portlandrobotics/btServo/README.md

btServo
=======

PARTS hobby servo controller project
