portlandrobotics/btServo/hardware/kicad/parts_servo.kicad_pcb

## KiCad design hardware/kicad/parts_servo.kicad_pcb (2015-05-14)

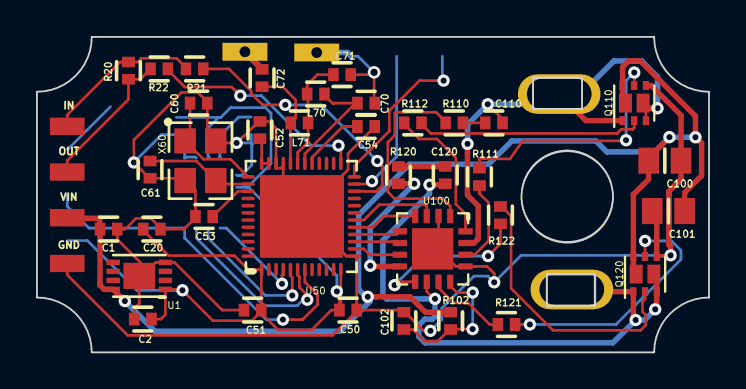
[picture p1: board parts_servo.kicad_pcb from above]

Board: 2 copper layers, 37.3 x 17.5 mm, 47 parts (0 on the bottom side), 43 nets.

Parts:
C1: 1uF 10V; 0402-B
C2, C102, C110, C120: 1uF; 0402-B
C20, C50, C51, C53, C203: 0.1uF; 0402-B
C52: 0.001uF; 0402-B
C54: 0.047uF; 0402-B
C60, C61: 8pF; 0402-B
C70: 0.0022uF; 0402-B
C71: np; 0402-B
C72: 2,2pF; 0402-B
C100, C101: 10uF 10V; 0805-B
C204: 4u7; 0402-B
JP1, JP3: M01; SMDMOTOR
JP2: Input; SMD_1X4_HEADER
JP4: SWD; SMD_1X3_PADS
JP5: POT; SMD_1X3_PADS
L70: 10nH; 0402-B
L71: 4.7nH; 0402-B
Q110, Q120: NFET-DUAL; PMDPB28UN
R20: 120 (np); 0402-B
R21, R22: 4.7K (np); 0402-B
R102, R111, R112, R121, R122: 2.2; 0402-B
R110, R120: 1; 0402-B
R201: 15; 0402-B
TP1: ANT1; TESTPOINT-(1X1)CREAMED
TP2: ANT_FEED; TESTPOINT-(1X1)CREAMED
U1: MCP1703-3302; MCP1703
U50: NRF51822
U100: RT9625A; QFN-16(4X4)+EP
U200: AS5050
X60: 16MHz; CRYSTAL-3.2X2.5(4_TERMINAL)

Connections:
+3.3V: C2.1, C20.1, C50.1, C51.1, C203.1, JP5.3, R201.2, U1.1, U50.1, U50.12, U200.11, U200.14
/PWR_IN: C1.1, C100.1, C101.1, JP2.2, Q110.6, Q110.P7, Q120.6, Q120.P7, R102.2, U1.8
/PWR_MotorA: C120.2, JP1.1, Q120.1, Q120.3, Q120.P8, U100.10
/PWR_MotorB: C110.2, JP3.1, Q110.1, Q110.3, Q110.P8, U100.15
/UNIPOLAR_INPUT: R21.2, U50.22
/UNIPOLAR_OUTPUT: R22.2, U50.25
AVDD: C52.1, U50.35, U50.36
GND: C1.2, C2.2, C20.2, C50.2, C51.2, C52.2, C53.2, C54.2, C60.2, C61.2, C70.2, C71.2, C100.2, C101.2, C102.2, C203.2, C204.1, JP2.1, JP4.3, JP5.1, Q110.4, Q120.4, TP1.TP, U1.4, U1.PAD, U50.13, U50.33, U50.34, U50.PAD, U100.2, U100.13, U100.PAD, U200.9, U200.10, U200.13, X60.2, X60.4
unnamed: C53.1, U50.39
unnamed: C54.1, U50.29
unnamed: C60.1, U50.37, X60.1
unnamed: C61.1, U50.38, X60.3
unnamed: C70.1, L70.2, U50.30
unnamed: C71.1, L70.1, L71.2, U50.31
unnamed: C72.1, L71.1, U50.32
unnamed: C72.2, TP2.TP
unnamed: C102.1, R102.1, U100.12
unnamed: C110.1, R110.2
unnamed: C120.1, R120.2
unnamed: C204.2, R201.1, U200.12
unnamed: JP2.3, R20.2, R22.1
unnamed: JP2.4, R20.1, R21.1
unnamed: JP4.1, U50.24
unnamed: JP4.2, U50.23
unnamed: JP5.2, U50.7, U200.4
unnamed: Q110.2, R112.2
unnamed: Q110.5, R111.2
unnamed: Q120.2, R122.2
unnamed: Q120.5, R121.2
unnamed: R110.1, U100.1
unnamed: R111.1, U100.14
unnamed: R112.1, U100.16
unnamed: R120.1, U100.8
unnamed: R121.1, U100.11
unnamed: R122.1, U100.9
unnamed: U50.18, U100.3
unnamed: U50.17, U100.4
unnamed: U50.16, U100.5
unnamed: U50.15, U100.6
unnamed: U50.14, U100.7
unnamed: U50.4, U200.1
unnamed: U50.5, U200.2
unnamed: U50.6, U200.3
