portlandrobotics/btServo/hardware/eagle/parts_servo.brd

## EAGLE design hardware/eagle/parts_servo.brd (2015-04-11)

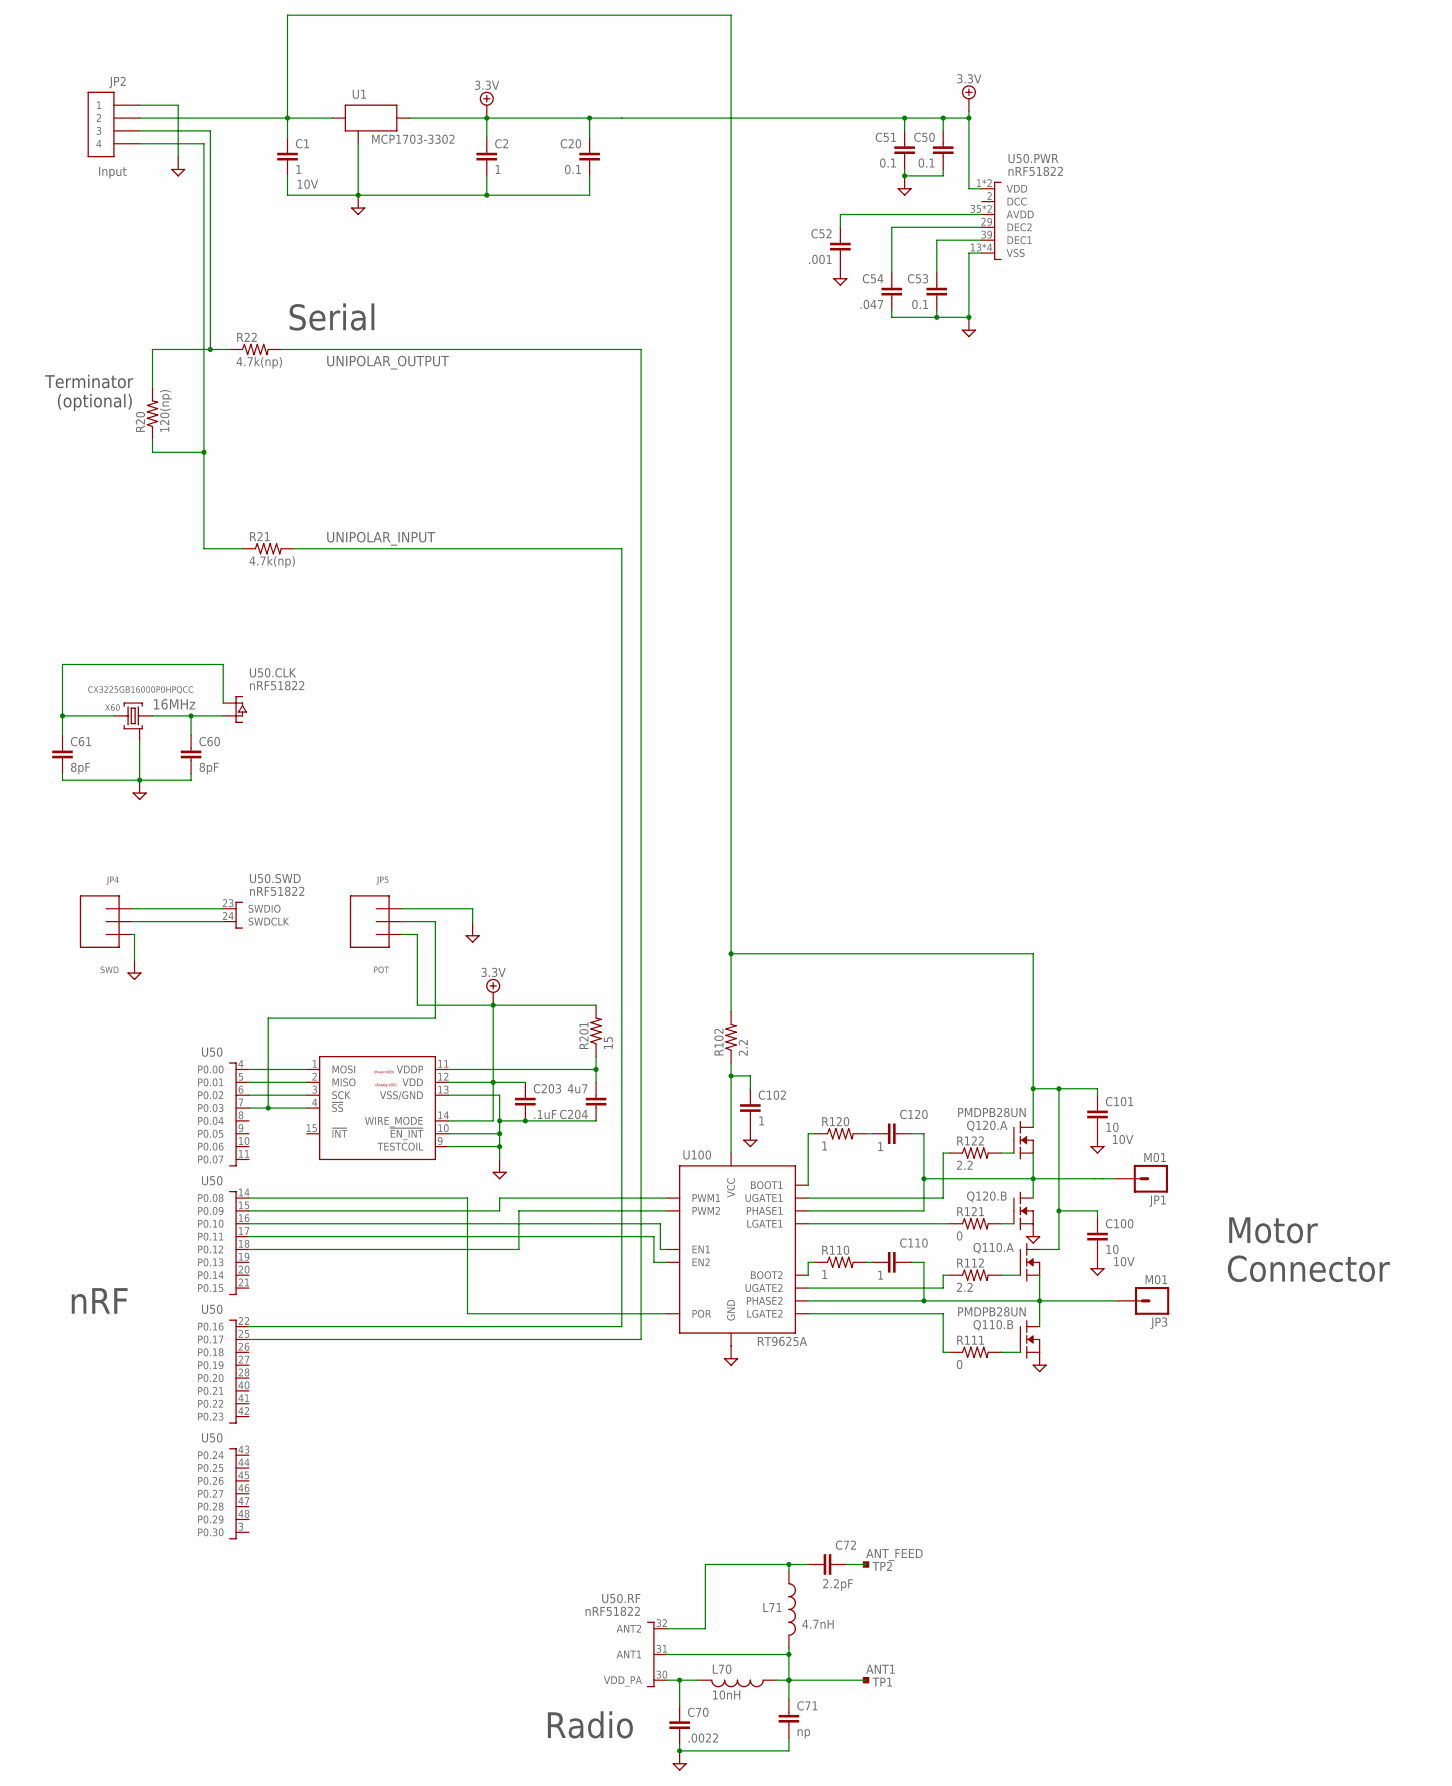
[picture p2: schematic parts_servo.sch]

Parts:
C1: 1; 0402-B; VOLTAGE 10V
C2, C102, C110, C120: 1; 0402-B
C20, C50, C51, C53: 0.1; 0402-B
C52: .001; 0402-B
C54: .047; 0402-B
C60, C61: 8pF; 0402-B
C70: .0022; 0402-B
C71: np; 0402-B
C72: 2.2pF; 0402-B
C100, C101: 10; 0805-B; VOLTAGE 10V
C203: .1uF; 0402-B
C204: 4u7; 0402-B
JP1, JP3: M01; SMDMOTOR
JP2: Input; SMD_1X4_HEADER
JP4: SWD; SMD_1X3_HEADER
JP5: POT; SMD_1X3_PADS
L70: 10nH; 0402-B
L71: 4.7nH; 0402-B
Q110, Q120: PMDPB28UN; DFN-6(2X2)+2EP(TRANSISTOR)
R20: 120(np); 0402-B
R21, R22: 4.7k(np); 0402-B
R102, R112, R122: 2.2; 0402-B
R110, R120: 1; 0402-B
R111, R121: 0; 0402-B
R201: 15; 0402-B
TP1: ANT1; TESTPOINT-(1X1)CREAMED
TP2: ANT_FEED; TESTPOINT-(1X1)CREAMED
U1: MCP1703-3302; DFN-8(2X3)+EP
U50: nRF51822; DFN-48(6X6)+EP
U100: RT9625A; QFN-16(4X4)+EP
U200: AS5050; QFN16_4X4
X60: CX3225GB16000P0HPQCC; CRYSTAL-3.2X2.5(4_TERMINAL)

Connections:
3.3V: C2.1, C20.1, C50.1, C51.1, C203.1, JP5.3, R201.2, U1.1 (OUT), U50.1 (VDD), U50.12 (VDD), U200.12 (VDD), U200.14 (WIRE_MODE)
ANT1: C71.1, L70.1, L71.2, TP1.TP, U50.31 (ANT1)
ANT2: C72.1, L71.1, U50.32 (ANT2)
ANT_FEED: C72.2, TP2.TP
AVDD: C52.1, U50.35 (AVDD), U50.36 (AVDD)
BOOT1: R120.1, U100.8 (BOOT1)
BOOT1_SNUB: C120.1, R120.2
BOOT1_SNUB1: C110.1, R110.2
BOOT2: R110.1, U100.1 (BOOT2)
D1/TX: JP2.3, R20.2, R22.1
D2/RX: JP2.4, R20.1, R21.1
DEC1: C53.1, U50.39 (DEC1)
DEC2: C54.1, U50.29 (DEC2)
GND: C1.2, C2.2, C20.2, C50.2, C51.2, C52.2, C53.2, C54.2, C60.2, C61.2, C70.2, C71.2, C100.2, C101.2, C102.2, C203.2, C204.1, JP2.1, JP4.P$3 (3), JP5.1, Q110.4 (S), Q120.4 (S), U1.4 (GND), U1.PAD (GND), U50.13 (VSS), U50.33 (VSS), U50.34 (VSS), U50.PAD (VSS), U100.2 (GND), U100.13 (GND), U100.PAD (GND), U200.9 (TESTCOIL), U200.10 (!EN_INT), U200.13 (VSS/GND), X60.2 (SHIELD), X60.4 (SHIELD)
HSCLK_IN: C60.1, U50.37 (CLKIN), X60.1
HSCLK_OUT: C61.1, U50.38 (CLKOUT), X60.3 (2)
LGATE1: R121.1, U100.11 (LGATE1)
LGATE2: R111.1, U100.14 (LGATE2)
MOTOR1: C120.2, JP1.1, Q120.1 (S), Q120.3 (D), Q120.P8 (D), U100.10 (PHASE1)
MOTOR2: C110.2, JP3.1, Q110.1 (S), Q110.3 (D), Q110.P8 (D), U100.15 (PHASE2)
unnamed: U50.4 (P0.00), U200.1 (MOSI)
unnamed: U50.5 (P0.01), U200.2 (MISO)
unnamed: U50.6 (P0.02), U200.3 (SCK)
unnamed: JP5.2, U50.7 (P0.03), U200.4 (!SS)
unnamed: C204.2, R201.1, U200.11 (VDDP)
POWER_IN: C1.1, C100.1, C101.1, JP2.2, Q110.6 (D), Q110.P7 (D), Q120.6 (D), Q120.P7 (D), R102.2, U1.8 (IN)
PWM1: U50.15 (P0.09), U100.6 (PWM1)
PWM1_EN: U50.16 (P0.10), U100.5 (EN1)
PWM2: U50.18 (P0.12), U100.3 (PWM2)
PWM2_EN: U50.17 (P0.11), U100.4 (EN2)
PWM_POR: U50.14 (P0.08), U100.7 (POR)
PWM_VCC: C102.1, R102.1, U100.12 (VCC)
QLGATE1: Q120.5 (G), R121.2
QLGATE2: Q110.5 (G), R111.2
QUGATE1: Q120.2 (G), R122.2
QUGATE2: Q110.2 (G), R112.2
SWDCLK: JP4.P$2 (2), U50.24 (SWDCLK)
SWDIO: JP4.P$1 (1), U50.23 (SWDIO)
UGATE1: R122.1, U100.9 (UGATE1)
UGATE2: R112.1, U100.16 (UGATE2)
UNIPOLAR_INPUT: R21.2, U50.22 (P0.16)
UNIPOLAR_OUTPUT: R22.2, U50.25 (P0.17)
VDD_PA: C70.1, L70.2, U50.30 (VDD_PA)

Notes on the sheet:
nRF
Motor Connector
Terminator (optional)
Radio
Serial

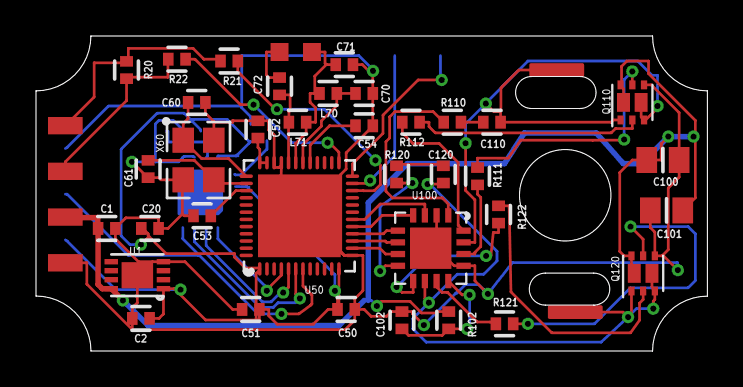
[picture p3: board parts_servo.brd from above]

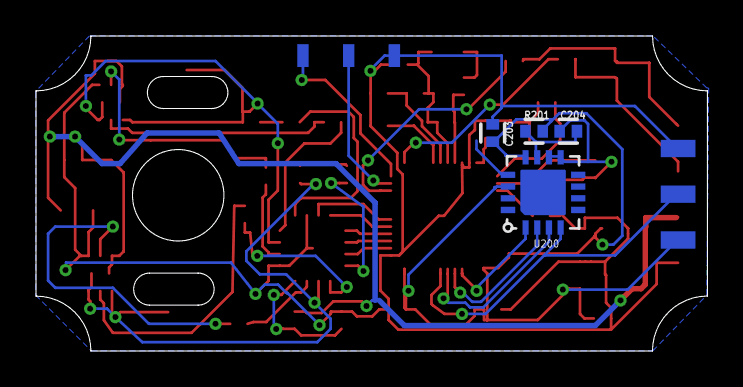
[picture p4: board parts_servo.brd from below]

Board: 2 copper layers, 37.3 x 17.5 mm, 47 parts (6 on the bottom side), 43 nets.
