portlandrobotics/btServo/(commit log)

2014-04-14 Initial prototype design by Tim
    [parts_servo.brd, parts_servo.sch]
2014-04-15 Initial layout
    [parts_servo.brd, parts_servo.sch]
2014-04-15 Removed all the DRC errors.
    [parts_servo.brd]
2014-04-15 resize vias for LPKF
    [parts_servo.brd]
2014-04-15 Fix DRC errors from via resize
    [parts_servo.brd]
2014-04-15 Fatten some traces, fix DRC and routing
    [parts_servo.brd]
2014-04-15 Move programming header to edge of board
    [parts_servo.brd]
2014-04-16 Connect the center pad on the QFN48 to GND.
2014-04-16 Connect NRF center pad to GND. Add ground pour on bottom of board to improve current return from motor FETs.
    [parts_servo.brd, parts_servo.sch]
2014-04-16 Clean up silkscreen text
    [parts_servo.brd]
2014-04-16 Set bottom fill to net GND. Added mounting holes and a few extra GND vias.
    [parts_servo.brd]
2014-05-07 Initial firmware test based on Nordic pwm code
2014-05-13 Added ADC read code, and a basic PWM function. Replaced main loop to call them.
    [main.c]
2014-06-10 First pass at BLE radio control of servo. Very crude proportional control based on potentiometer feedback. Radio code based on Nordic BLE based UART example.
2014-07-24 Disable timeout by switching to general discovery mode. Implement new communication protocol and register map.
2014-09-08 Second rev of board design. Shrink to servo case size
    [parts_servo.brd, parts_servo.sch]
2014-09-10 Update pin mapping for new board and SPI commands for the AS5050. Doesn't seem to work though.
    [main.c]
2014-09-12 Wrote some AS5050 code to reset the chip on boot and if it reports an error. This is all untested, since I don't have a working part at the moment.
    [main.c]
2014-09-12 Fix factor of 4 error in position reading.
    [main.c]
2015-01-05 Add first version of KiCAD hardware files
    [parts_servo.brd, parts_servo.kicad_pcb, parts_servo.sch]
2015-01-14 Fix incorrect connections on AS5050
    [parts_servo.kicad_pcb, parts_servo.sch]
2015-03-17 New board layout. Version sent to DirtyPCBs for thinner boards
    [parts_servo.kicad_pcb, parts_servo.sch]
2015-04-11 Initial commit of prototype android app.
2015-04-21 Rev protocol to add command to response message. Add target arrow to wheel display. Add motor switch.
2015-05-14 correct motor direction control (reverse it)
    [main.c]
2015-05-14 board layout cleanup
    [parts_servo.kicad_pcb]
2015-08-31 Add pi filter to matching network. Clean up routing and create parts_servo2.kicad_pcb with latest changes
    [parts_servo.sch, parts_servo2.kicad_pcb]
2015-09-15 new board layout: parts_servo3.kicad_pcb
    [parts_servo3.kicad_pcb]
